grasevski/midiguitar/schematic/midiguitarpcb.kicad_pcb

## KiCad design schematic/midiguitarpcb.kicad_pcb (2026-02-02)

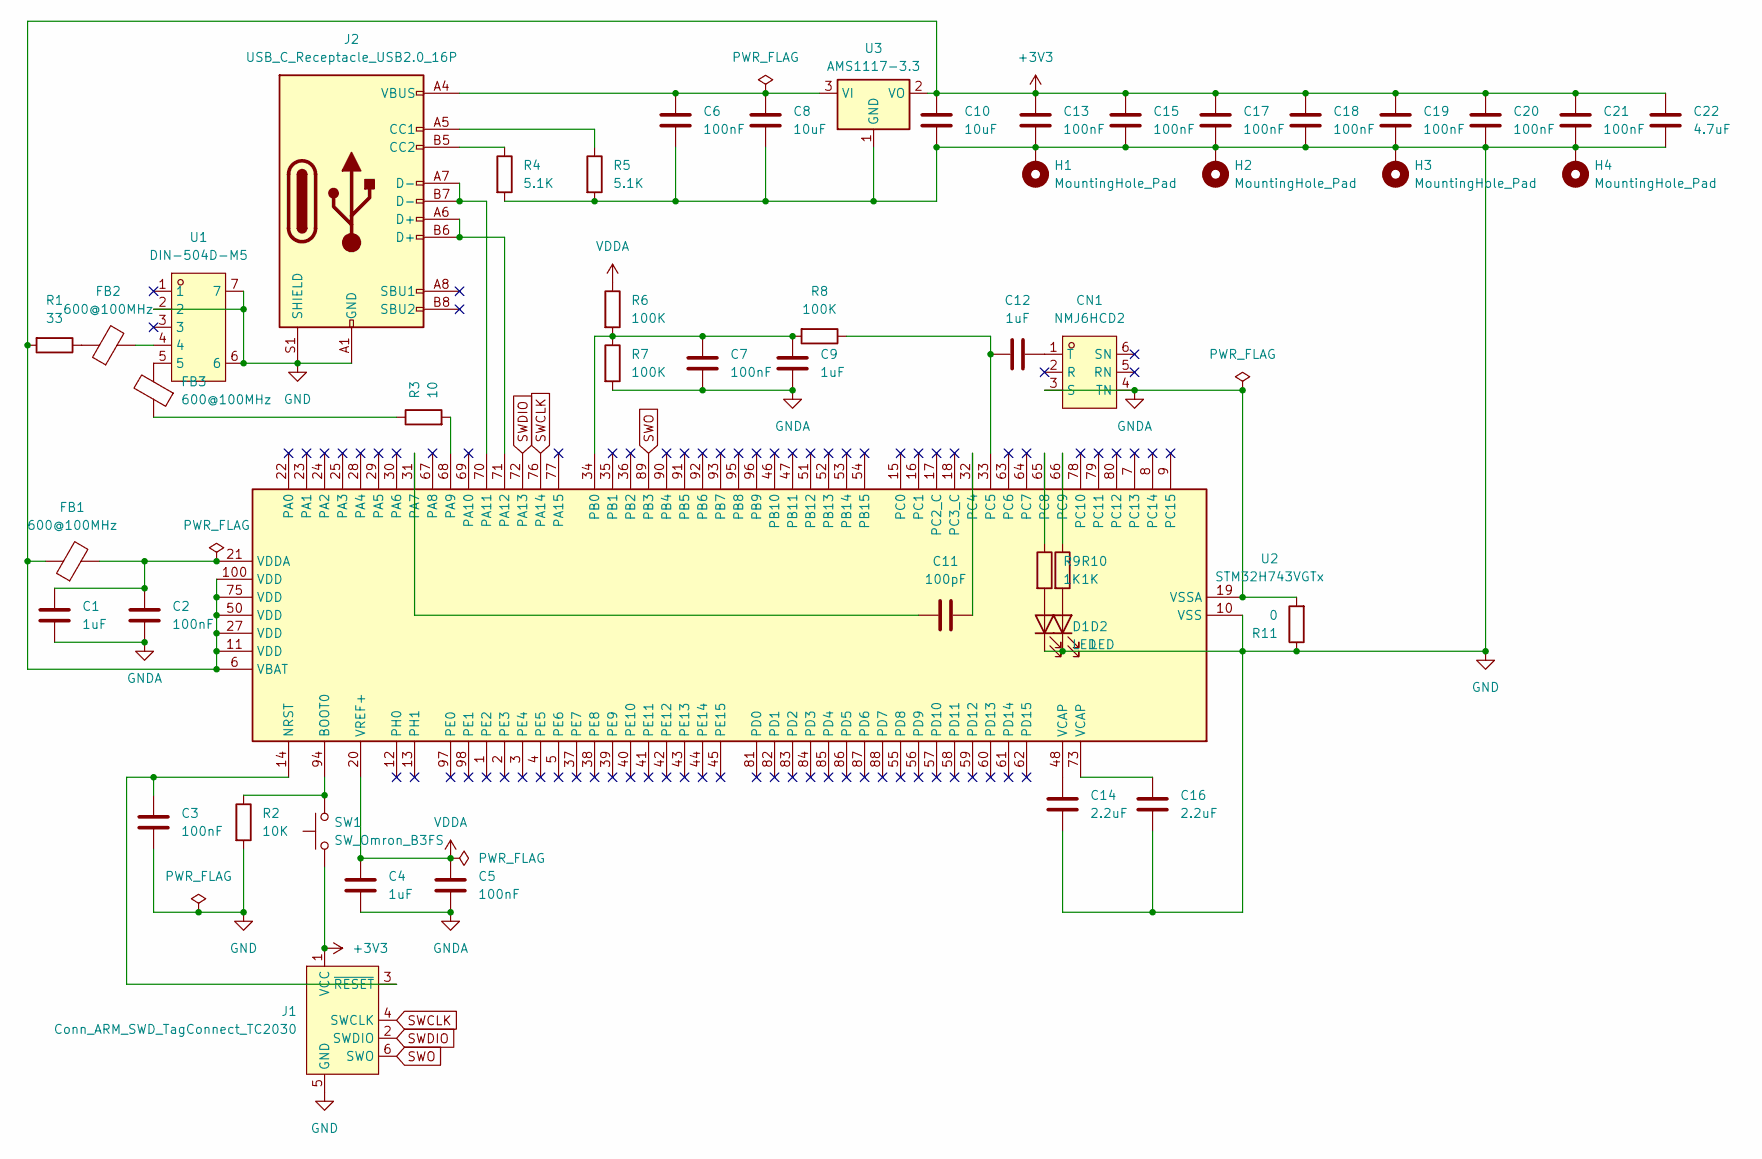
[picture p1: schematic midiguitarpcb.kicad_sch]

Parts:
C1, C4, C9, C12: 1uF; C_0603_1608Metric
C2, C3, C5, C6, C7, C13, C15, C17, C18, C19, C20, C21: 100nF; C_0603_1608Metric
C8, C10: 10uF; C_0603_1608Metric
C11: 100pF; C_0603_1608Metric
C14, C16: 2.2uF; C_0603_1608Metric
C22: 4.7uF; C_0603_1608Metric
CN1: NMJ6HCD2; AUDIO-TH_NMJ6HCD2; LCSC Part C368502
D1, D2: LED; LED_0603_1608Metric
FB1, FB2, FB3: 600@100MHz; L_0603_1608Metric
H1, H2, H3, H4: MountingHole_Pad; MountingHole_3.2mm_M3_Pad
J1: Conn_ARM_SWD_TagConnect_TC2030; Tag-Connect_TC2030-IDC-FP_2x03_P1.27mm_Vertical
J2: USB_C_Receptacle_USB2.0_16P; USB_C_Receptacle_HRO_TYPE-C-31-M-12
R1: 33; R_0603_1608Metric
R2: 10K; R_0603_1608Metric
R3: 10; R_0603_1608Metric
R4, R5: 5.1K; R_0603_1608Metric
R6, R7, R8: 100K; R_0603_1608Metric
R9, R10: 1K; R_0603_1608Metric
R11: 0; R_0603_1608Metric
SW1: SW_Omron_B3FS; SW_SPST_Omron_B3FS-100xP
U1: DIN-504D-M5; CONN-TH_DIN-504D-M5; LCSC Part C2939347
U2: STM32H743VGTx; LQFP-100_14x14mm_P0.5mm
U3: AMS1117-3.3; SOT-223-3_TabPin2

Connections:
+3V3: C10.1, C13.1, C15.1, C17.1, C18.1, C19.1, C20.1, C21.1, C22.1, FB1.1, J1.1 (VCC), R1.2, SW1.1, U2.6 (VBAT), U2.11 (VDD), U2.27 (VDD), U2.50 (VDD), U2.75 (VDD), U2.100 (VDD), U3.2 (VO)
GND: C3.1, C6.2, C8.2, C10.2, C13.2, C14.2, C15.2, C16.2, C17.2, C18.2, C19.2, C20.2, C21.2, C22.2, D1.1 (K), D2.1 (K), H1.1, H2.1, H3.1, H4.1, J1.5 (GND), J2.A1 (GND), J2.A12 (GND), J2.B1 (GND), J2.B12 (GND), J2.S1 (SHIELD), R2.2, R4.2, R5.2, R11.1, U1.2, U1.6, U1.7, U2.10 (VSS), U2.26 (VSS), U2.49 (VSS), U2.74 (VSS), U2.99 (VSS), U3.1 (GND)
GNDA: C1.2, C2.2, C4.2, C5.2, C7.2, C9.2, CN1.3 (S), CN1.4 (TN), R7.2, R11.2, U2.19 (VSSA)
unnamed: C14.1, U2.48 (VCAP)
unnamed: C16.1, U2.73 (VCAP)
unnamed: C12.1, CN1.1 (T)
unnamed: D1.2 (A), R9.2
unnamed: D2.2 (A), R10.2
unnamed: FB2.1, R1.1
unnamed: FB2.2, U1.4
unnamed: FB3.1, R3.1
unnamed: FB3.2, U1.5
unnamed: C3.2, J1.3 (~RESET), U2.14 (NRST)
unnamed: J2.A5 (CC1), R5.1
unnamed: J2.B5 (CC2), R4.1
unnamed: R2.1, SW1.2, U2.94 (BOOT0)
unnamed: C11.2, U2.31 (PA7)
unnamed: R3.2, U2.68 (PA9)
unnamed: J2.A7 (D-), J2.B7 (D-), U2.70 (PA11)
unnamed: J2.A6 (D+), J2.B6 (D+), U2.71 (PA12)
unnamed: C7.1, C9.1, R6.2, R7.1, R8.2, U2.34 (PB0)
unnamed: C11.1, U2.32 (PC4)
unnamed: C12.2, R8.1, U2.33 (PC5)
unnamed: R9.1, U2.65 (PC8)
unnamed: R10.1, U2.66 (PC9)
unnamed: C1.1, C2.1, FB1.2, U2.21 (VDDA)
unnamed: C6.1, C8.1, J2.A4 (VBUS), J2.A9 (VBUS), J2.B4 (VBUS), J2.B9 (VBUS), U3.3 (VI)
SWCLK: J1.4 (SWCLK), U2.76 (PA14)
SWDIO: J1.2 (SWDIO), U2.72 (PA13)
SWO: J1.6 (SWO), U2.89 (PB3)
VDDA: C4.1, C5.1, R6.1, U2.20 (VREF+)

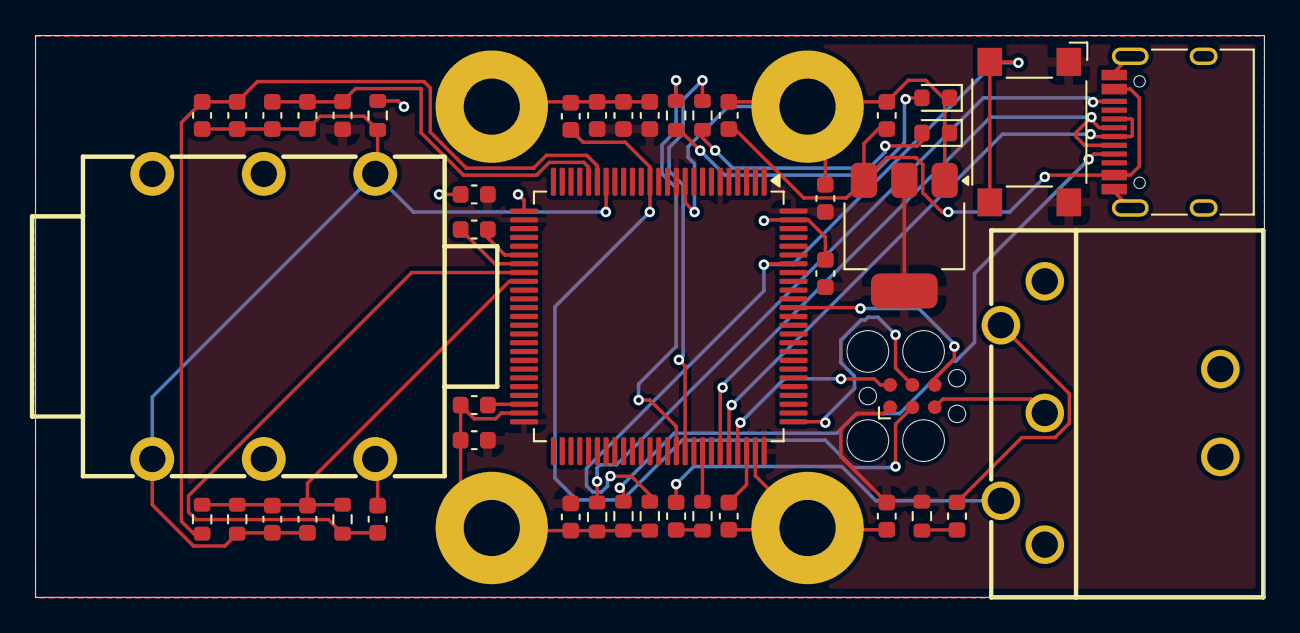
[picture p2: board midiguitarpcb.kicad_pcb from above]

Board: 2 copper layers, 70.0 x 32.0 mm, 49 parts (0 on the bottom side), 31 nets.
