grasevski/midiguitar/src/Core/Src/main.c

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
/* Includes ------------------------------------------------------------------*/
#include "main.h"
#include "usb_device.h"

/* USER CODE BEGIN Includes */
#include "usbd_cdc_if.h"
#include "midiguitar.h"
/* USER CODE END Includes */

ADC_HandleTypeDef hadc1;
DMA_HandleTypeDef hdma_adc1;

UART_HandleTypeDef hlpuart1;
DMA_HandleTypeDef hdma_lpuart1_tx;

OPAMP_HandleTypeDef hopamp1;

void SystemClock_Config(void);
static void MPU_Config(void);
static void MX_GPIO_Init(void);
static void MX_BDMA_Init(void);
static void MX_DMA_Init(void);
static void MX_LPUART1_UART_Init(void);
static void MX_ADC1_Init(void);
static void MX_OPAMP1_Init(void);
/**
  * @brief  The application entry point.
  * @retval int
  */
int main(void)
{

  /* MPU Configuration--------------------------------------------------------*/
  MPU_Config();

  /* MCU Configuration--------------------------------------------------------*/

  /* Reset of all peripherals, Initializes the Flash interface and the Systick. */
  HAL_Init();

  /* Configure the system clock */
  SystemClock_Config();

  /* Initialize all configured peripherals */
  MX_GPIO_Init();
  MX_BDMA_Init();
  MX_DMA_Init();
  MX_LPUART1_UART_Init();
  MX_ADC1_Init();
  MX_OPAMP1_Init();
  MX_USB_DEVICE_Init();
  /* USER CODE BEGIN 2 */
  HAL_OPAMP_Start(&hopamp1);
  enum { N_INPUT = SAMPLES << 1 };
  __attribute__((section(".dma"))) static uint16_t inbuf[N_INPUT];
  bzero(inbuf, sizeof(inbuf));
  struct midiguitar mg = {};
  HAL_GPIO_WritePin(GPIOC, GPIO_PIN_8, GPIO_PIN_SET);
  HAL_ADC_Start_DMA(&hadc1, (uint32_t *)inbuf, N_INPUT);
  /* USER CODE END 2 */

  /* Infinite loop */
  /* USER CODE BEGIN WHILE */
  while (1)
  {
    const uint16_t k = __HAL_DMA_GET_COUNTER(hadc1.DMA_Handle);
    float input[SAMPLES];
    int32_t s = 0;
    for (uint16_t i = 0; i < SAMPLES; ++i) s += inbuf[(N_INPUT - k + i + SAMPLES) & (N_INPUT - 1)];
    s /= SAMPLES;
    for (uint16_t i = 0; i < SAMPLES; ++i)
      input[i] = (inbuf[(N_INPUT - k + i + SAMPLES) & (N_INPUT - 1)] - s) / 32768.0;
    __attribute__((section(".bdma"))) static uint8_t output[MIDI_CAP];
    const int t0 = HAL_GetTick();
    const int n = midiguitar(&mg, input, output);
    const int t1 = HAL_GetTick();
    if (!n) continue;
    while (HAL_UART_GetState(&hlpuart1) != HAL_UART_STATE_READY);
    HAL_UART_Transmit_DMA(&hlpuart1, output, n);
    __attribute__((section(".dma"))) static uint8_t telemetry[64];
    const int8_t l = sprintf((char *)telemetry, "%d %d %d\r\n", n, t1 - t0, (int)inbuf[0]);
    CDC_Transmit_FS(telemetry, l);
    HAL_GPIO_TogglePin(GPIOC, GPIO_PIN_9);
    /* USER CODE END WHILE */

    /* USER CODE BEGIN 3 */
  }
  /* USER CODE END 3 */
}

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
 /* MPU Configuration */

void MPU_Config(void)
{
  MPU_Region_InitTypeDef MPU_InitStruct = {0};

  /* Disables the MPU */
  HAL_MPU_Disable();

  /** Initializes and configures the Region and the memory to be protected
  */
  MPU_InitStruct.Enable = MPU_REGION_ENABLE;
  MPU_InitStruct.Number = MPU_REGION_NUMBER0;
  MPU_InitStruct.BaseAddress = 0x0;
  MPU_InitStruct.Size = MPU_REGION_SIZE_4GB;
  MPU_InitStruct.SubRegionDisable = 0x87;
  MPU_InitStruct.TypeExtField = MPU_TEX_LEVEL0;
  MPU_InitStruct.AccessPermission = MPU_REGION_NO_ACCESS;
  MPU_InitStruct.DisableExec = MPU_INSTRUCTION_ACCESS_DISABLE;
  MPU_InitStruct.IsShareable = MPU_ACCESS_SHAREABLE;
  MPU_InitStruct.IsCacheable = MPU_ACCESS_NOT_CACHEABLE;
  MPU_InitStruct.IsBufferable = MPU_ACCESS_NOT_BUFFERABLE;

  HAL_MPU_ConfigRegion(&MPU_InitStruct);
  /* Enables the MPU */
  HAL_MPU_Enable(MPU_PRIVILEGED_DEFAULT);

}

/**
  * @brief  This function is executed in case of error occurrence.
  * @retval None
  */
void Error_Handler(void)
{
  /* USER CODE BEGIN Error_Handler_Debug */
  /* User can add his own implementation to report the HAL error return state */
  __disable_irq();
  while (1)
  {
  }
  /* USER CODE END Error_Handler_Debug */
}
#ifdef USE_FULL_ASSERT
/**
  * @brief  Reports the name of the source file and the source line number
  *         where the assert_param error has occurred.
  * @param  file: pointer to the source file name
  * @param  line: assert_param error line source number
  * @retval None
  */
void assert_failed(uint8_t *file, uint32_t line)
{
  /* USER CODE BEGIN 6 */
  /* User can add his own implementation to report the file name and line number,
     ex: printf("Wrong parameters value: file %s on line %d\r\n", file, line) */
  /* USER CODE END 6 */
}
#endif /* USE_FULL_ASSERT */
