grasevski/midiguitar/src/src.ioc

Mcu.UserName=STM32H743VGTx
PA10.Signal=LPUART1_RX
PA11.Signal=USB_OTG_FS_DM
PA12.Signal=USB_OTG_FS_DP
PA7.Signal=OPAMP1_VINM1
PA9.Signal=LPUART1_TX
PB0.Signal=OPAMP1_VINP
PC4.Signal=OPAMP1_VOUT
PC5.Signal=OPAMP1_VINM0
PC8.Signal=GPIO_Output
PC9.Signal=GPIO_Output
