grasevski/midiguitar/(commit log)

2026-01-05 wip working but noisy
    [midiguitarpcb.kicad_pcb, midiguitarpcb.kicad_sch]
2026-01-14 redo pcb
    [midiguitar.scad, midiguitarpcb.kicad_pcb, midiguitarpcb.kicad_sch]
2026-01-22 wip about to put in mounting holes
    [midiguitarpcb.kicad_pcb, midiguitarpcb.kicad_sch]
2026-01-27 wip about to put leds in
    [midiguitarpcb.kicad_pcb, midiguitarpcb.kicad_sch]
2026-02-02 skinny pcb
    [midiguitar.scad, midiguitarpcb.kicad_pcb, midiguitarpcb.kicad_sch]
2026-03-02 feat(perf): reinstate zero padding
    See if it runs faster to use zero padding rather than the entire 4096
    samples for the grid.
2026-03-03 chore(perf): better sample size
